brotulix/arduino-bottlerocket/arduino_nano_v3_pinout.jpg

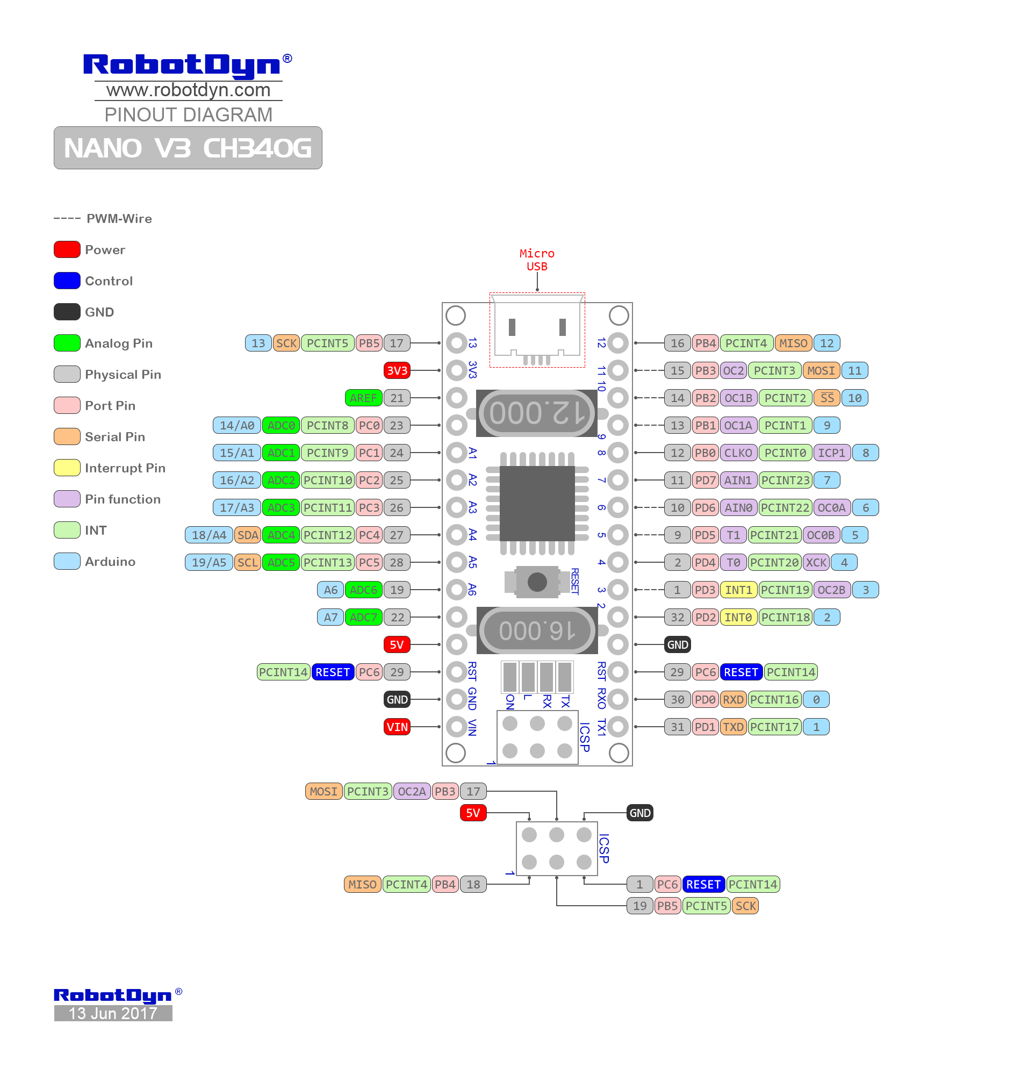
arduino_nano_v3_pinout.jpg
