brotulix/arduino-bottlerocket/doc/images/2019-07-19_Launch_02/Akselerasjon.png

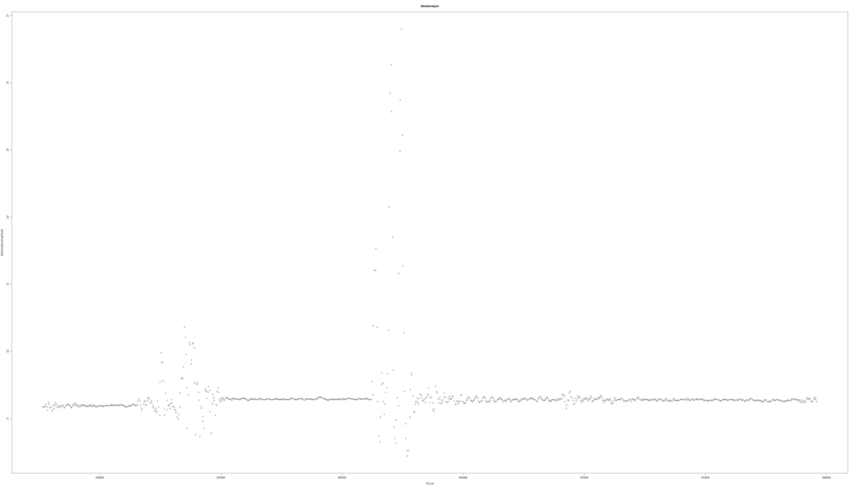
doc/images/2019-07-19_Launch_02/Akselerasjon.png
