brotulix/arduino-bottlerocket/doc/images/2019-07-19_Launch_02/Akszoom.png

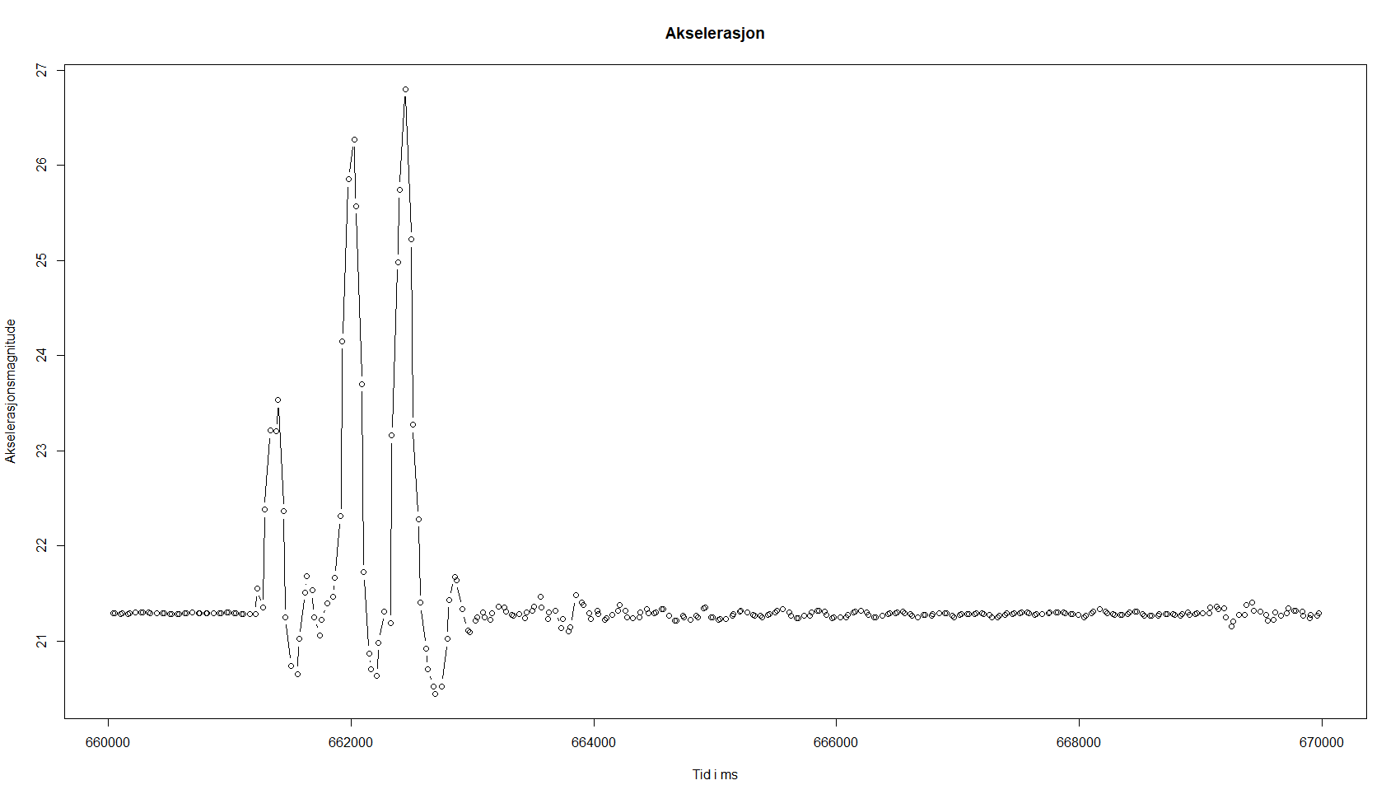
doc/images/2019-07-19_Launch_02/Akszoom.png
