brotulix/arduino-bottlerocket/doc/images/2019-07-19_Launch_02/Trykk_over_tid.png

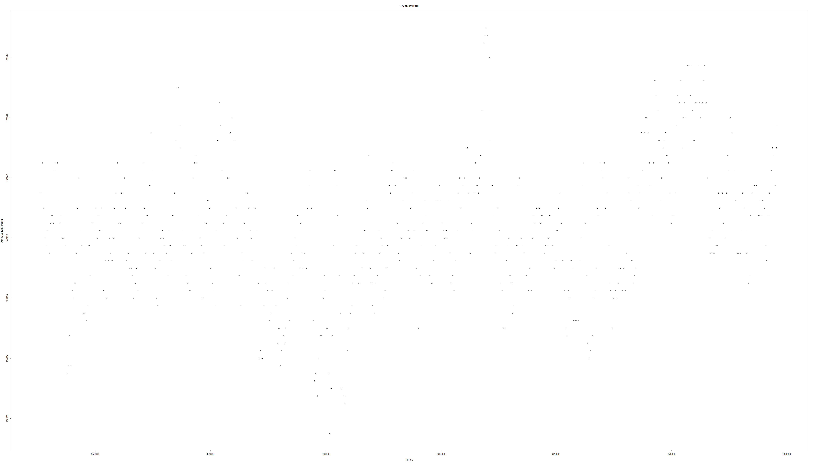
doc/images/2019-07-19_Launch_02/Trykk_over_tid.png
