brotulix/arduino-bottlerocket/doc/images/2019-07-19_Launch_02/Trykkliten.png

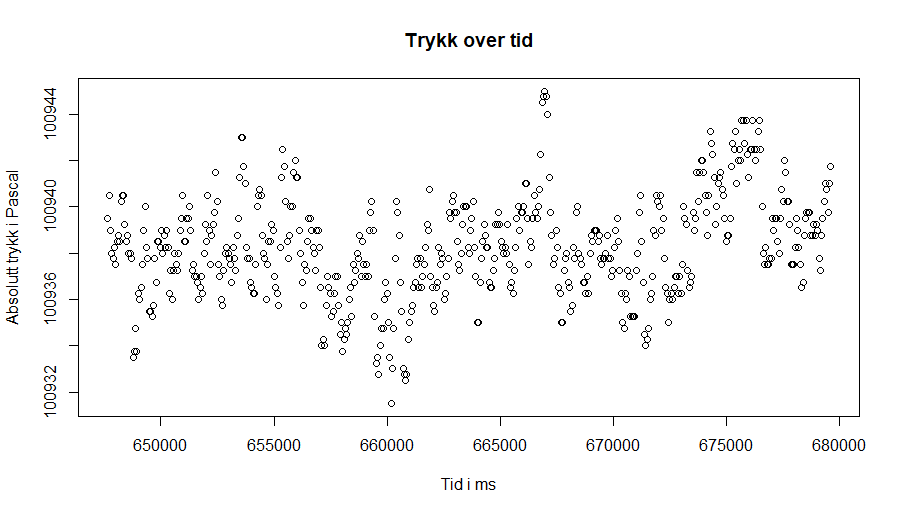
doc/images/2019-07-19_Launch_02/Trykkliten.png
