brotulix/arduino-bottlerocket/doc/images/Screenshot at 2019-07-07 14-47-54.png

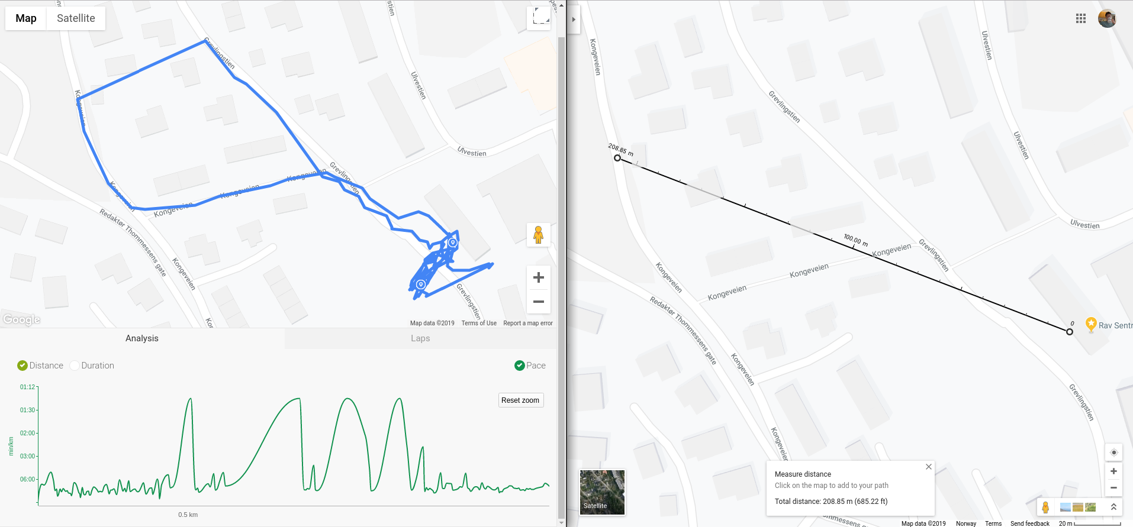
doc/images/Screenshot at 2019-07-07 14-47-54.png
