brotulix/arduino-bottlerocket/doc/images/Screenshot at 2019-07-08 00-21-22.png

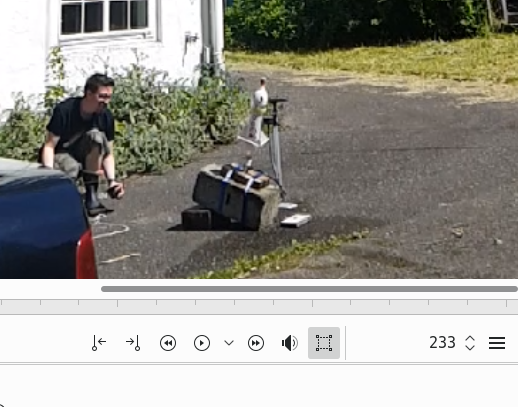
doc/images/Screenshot at 2019-07-08 00-21-22.png
