brotulix/arduino-bottlerocket/doc/images/Screenshot at 2019-07-08 00-22-48.png

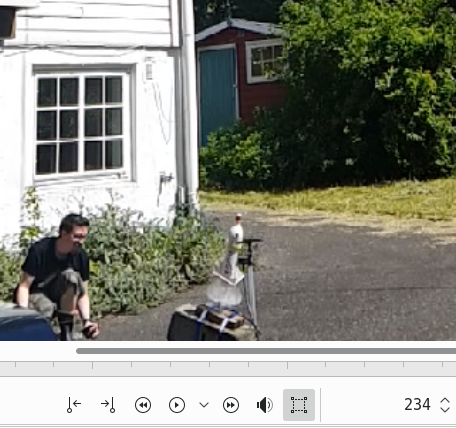
doc/images/Screenshot at 2019-07-08 00-22-48.png
