brotulix/arduino-bottlerocket/doc/images/Screenshot at 2019-07-19 22-26-23.png

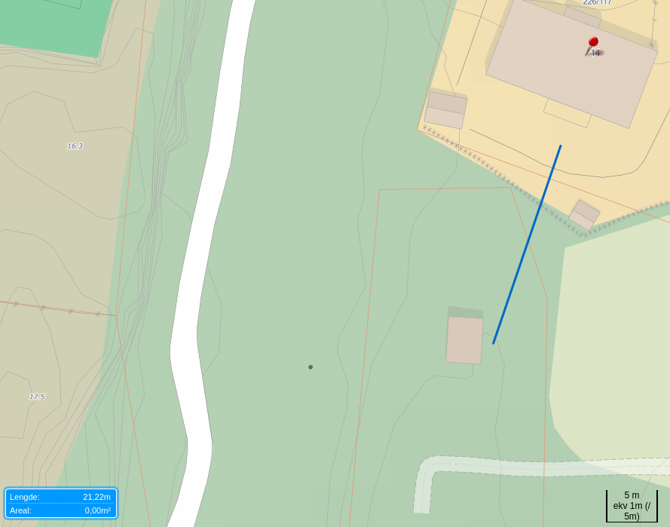
doc/images/Screenshot at 2019-07-19 22-26-23.png
