brotulix/arduino-bottlerocket/doc/2019-07-11_fishing_rod_test.ods

Sheet: Sheet1
Timestamp |  |  | prev_average | average | diff
20:57:13.899 161638 | R | A | 21.57 | 21.56 | 0
20:57:57.257 205033 | R | A | 21.56 | 21.56 | 0
20:57:57.334 205083 | R | A | 21.56 | 21.56 | 0
20:57:57.750 205177 | R | A | 21.56 | 21.56 | 0
20:57:58.126 205228 | R | A | 21.56 | 21.56 | 0
20:57:58.129 205322 | R | A | 21.56 | 21.56 | 0
20:57:58.455 205372 | R | A | 21.56 | 21.56 | 0
20:57:58.458 205466 | R | A | 21.57 | 21.56 | 0
20:57:58.465 205516 | R | A | 21.56 | 21.57 | 0
20:57:58.465 205611 | R | A | 21.57 | 21.57 | 0
20:57:58.465 205661 | R | A | 21.57 | 21.57 | 0
20:57:58.465 205755 | R | A | 21.57 | 21.56 | 0
20:57:58.468 205805 | R | A | 21.56 | 21.56 | 0
20:57:58.468 205899 | R | A | 21.56 | 21.56 | 0
20:57:58.473 205995 | R | A | 21.56 | 21.56 | 0
20:57:58.473 206091 | R | A | 21.55 | 21.55 | 0
20:57:58.473 206185 | R | A | 21.56 | 21.56 | 0
20:57:58.476 206235 | R | A | 21.56 | 21.56 | 0
20:57:58.552 206329 | R | A | 21.56 | 21.56 | 0
20:57:58.621 206380 | R | A | 21.56 | 21.56 | 0
20:57:58.705 206474 | R | A | 21.56 | 21.56 | 0
20:57:58.790 206524 | R | A | 21.56 | 21.56 | 0
20:57:58.875 206618 | R | A | 21.56 | 21.56 | 0
20:57:58.963 206668 | R | A | 21.56 | 21.56 | 0
20:57:58.985 206763 | R | A | 21.56 | 21.56 | 0
20:57:59.050 206813 | R | A | 21.56 | 21.56 | 0
20:57:59.133 206907 | R | A | 21.56 | 21.56 | 0
20:57:59.218 206956 | R | A | 21.56 | 21.56 | 0
20:57:59.304 207050 | R | A | 21.56 | 21.55 | 0
20:57:59.325 207101 | R | A | 21.55 | 21.55 | 0
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
00:11:13.429 1019994 | R | A | 23.49 | 23.49 | 0
00:11:13.481 1020044 | R | A | 23.49 | 23.49 | 0
00:11:13.569 1020138 | R | A | 23.49 | 23.49 | 0
00:11:13.611 1020188 | R | A | 23.49 | 23.49 | 0
00:11:13.700 1020282 | R | A | 23.5 | 23.49 | 0
00:11:16.763 1023347 | R | A | 23.49 | 23.49 | 0

Sheet: Sheet2
Timestamp |  |  | prev_average | average | diff
20:57:13.885 161602 | R | B | 100344 | 100346.38 | 2
20:57:57.270 205036 | R | B | 100340.13 | 100341 | 0
20:57:58.126 205180 | R | B | 100341 | 100342.38 | 1
20:57:58.131 205325 | R | B | 100342.38 | 100345.63 | 3
20:57:58.461 205469 | R | B | 100345.63 | 100347.5 | 1
20:57:58.465 205614 | R | B | 100347.5 | 100347.5 | 0
20:57:58.468 205758 | R | B | 100347.5 | 100345.88 | -1
20:57:58.468 205902 | R | B | 100345.88 | 100343.25 | -2
20:57:58.473 206045 | R | B | 100343.25 | 100342.63 | 0
20:57:58.473 206188 | R | B | 100342.63 | 100344.25 | 1
20:57:58.619 206332 | R | B | 100344.25 | 100343.5 | 0
20:57:58.707 206477 | R | B | 100343.5 | 100342.75 | 0
20:57:58.877 206621 | R | B | 100342.75 | 100343.25 | 0
20:57:59.048 206766 | R | B | 100343.25 | 100342.88 | 0
20:57:59.142 206910 | R | B | 100342.88 | 100343 | 0
20:57:59.308 207054 | R | B | 100343 | 100343.25 | 0
20:57:59.394 207153 | R | B | 100343.25 | 100342.75 | 0
20:57:59.565 207297 | R | B | 100342.75 | 100343.63 | 0
20:57:59.672 207441 | R | B | 100343.63 | 100343 | 0
20:57:59.821 207585 | R | B | 100343 | 100343.63 | 0
20:57:59.994 207730 | R | B | 100343.63 | 100342.5 | -1
20:58:00.164 207874 | R | B | 100342.5 | 100342.13 | 0
20:58:00.250 208018 | R | B | 100342.13 | 100340.5 | -1
20:58:00.421 208162 | R | B | 100340.5 | 100341.38 | 0
20:58:00.593 208307 | R | B | 100341.38 | 100342.63 | 1
20:58:00.679 208451 | R | B | 100342.63 | 100344.63 | 2
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
00:10:19.430 965964 | R | B | 100415.88 | 100415.38 | 0
00:10:19.600 966109 | R | B | 100415.38 | 100416.88 | 1
00:10:19.772 966253 | R | B | 100416.88 | 100417.38 | 0
00:10:19.859 966396 | R | B | 100417.38 | 100418 | 0
00:10:20.029 966542 | R | B | 100418 | 100418.25 | 0
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
