brotulix/arduino-bottlerocket/(threads)

Thread 3 (2019-07-04):

Implementer kommunikasjon over 433MHz

brotulix, 2019-07-04:
Få 433MHz-modulene konfigurert og fungerende.

brotulix, 2019-07-04:
Veldig lovende første prøve; plug & play på 9600 baud.
Må lese meg opp og skrive et Python-script og Arduino-driver for å sette opp baud rate til iallefall 19200. Definitivt verdt et forsøk å se om det går an å øke over dette også.

brotulix, 2019-07-08:
Første forsøk med å koble GPS direkte på modulen gikk ikke så bra... De første N meldingene gikk fint, men så begynte det å bli mye gibberish.
Jeg kobla på en Raspberry Pi som tok meldingene fra GPS på èn USB UART, filtrerte dem og spytta dem ut igjen på en annen USB UART. På den måten klarte jeg å få shippa over GPS-koordinater og kunne dra med meg Raspberryen på en tur rundt kvartalet, og fant ut at rekkevidden var på omtrent 200 meter line-of-sight.

Closed 2019-07-08.

Thread 4 (2019-07-08):

FET for å drive blinky blinky

brotulix, 2019-07-08:
Koble opp og test FET for å drive mer enn èn blinky blinky LED.

brotulix, 2019-07-08:
Var allerede implementert i software, nå også testet med hardware.

Closed 2019-07-08.

Thread 5 (2019-07-08):

FET for å en/disable servo når den ikke brukes

brotulix, 2019-07-08:
For å slippe at servoen står og jukker på akkurat feil vinkel enten på pad eller i recovery kan jeg tenke meg å styre supplyspenninga til den med en FET.

brotulix, 2019-07-08:
Implementert i software og testet med hardware.

Closed 2019-07-08.

Thread 9 (2019-07-08):

Funksjonstest på ekstern power

brotulix, 2019-07-08:
Kjør systemet på ekstern spenning
Sjekk at alle komponenter oppfører seg som forventa med ekstern spenning
Sjekk at spenningsavlesning fungerer
Sjekk at alle komponenter (inkludert low-battery-warning) oppfører seg som forventa med ekstern spenning helt ned til utladet batteri-spenning

brotulix, 2019-07-19:
Batteriavlesning trenger modifikasjon; spenninga leses ikke lenger nøyaktig når innspenning til Arduino blir for lav.
Ellers fungerer alt.

Closed 2019-07-19.
