brotulix/arduino-bottlerocket/botroc.ino

// If using eg. Visual Studio Code with Arduino plugin, ARDUINO may not be set:
#ifndef ARDUINO
#define ARDUINO 189
#endif

#include <Wire.h>
#include <Adafruit_Sensor.h>        // *modified* Adafruit Unified Sensor library
#include <Adafruit_BMP085_U.h>      // BMP085 Barometer
#include <Adafruit_ADXL345_U.h>     // ADXL345 Accelerometer
#include <Adafruit_HMC5883_U.h>     // HMC5883 Magnetometer
#include <Servo.h>

#define SET_BIT(a, b)   (a |= (0x1 << b))
#define CLEAR_BIT(a, b) (a &= ~(0x1 << b))
#define GET_BIT(a, b)   (a & (0x1 << b))

/*
#define INTSRC_INTERRUPT                        2
#define INTSRC_GYROMETER                        -1
#define INTSRC_BAROMETER                        4
#define INTSRC_THERMOMETER                      5
#define INTSRC_ACCELEROMETER                    6
#define INTSRC_MAGNETOMETER                     7
*/
#define SERVO_ENABLE_PIN                        7
#define BUZZER_PIN                              8
#define PARACHUTE_SERVO_PIN                     9
#define BLINKER_PIN                             10
#define I2C_SDA                                 18
#define I2C_SCL                                 19
#define BATTERY_VOLTAGE_PIN                     PIN_A2


#define STATUS_BAROMETER_DETECTED               0
#define STATUS_ACCELEROMETER_DETECTED           1
#define STATUS_GYROMETER_DETECTED               2
#define STATUS_MAGNETOMETER_DETECTED            3

#define STATUS_UPDATE                           0
#define STATUS_UPDATE_AVERAGE                   1
#define STATUS_REPORT                           2

#define STATE_GROUND_IDLE                       0   // ### Ground, idle state
#define STATE_GROUND_IDLE_ON_PAD                1   // ### Ground, on-pad idle state
#define STATE_GROUND_ARMED                      2   // ### Ground, armed state
#define STATE_AIRBORNE_OUTBOUND                 3   // ### Airborne, outbound state
#define STATE_AIRBORNE_DEPLOYMENT               4   // ### Airborne, deployment state
#define STATE_AIRBORNE_INBOUND                  5   // ### Airborne, inbound state
#define STATE_GROUND_RECOVERY                   6   // ### Ground, recovery state
#define STATE_GROUND_DATADUMP                   7   // ### Ground, data-dump state
#define STATE_MAX_STATE                         STATE_GROUND_RECOVERY

#define COMMAND_LINE_BUFFER_SIZE                16
#define COMMAND_LINE_APPEND_THRESHOLD           ((COMMAND_LINE_BUFFER_SIZE / 4) * 3)

#define SENSORS_NUM_VALUES                      8

typedef struct {
    float values[SENSORS_NUM_VALUES];
    float prev_average;
    float average;
    uint8_t filled_elements;
    uint8_t next_element_to_fill;
    uint16_t spare;
} savg;

typedef struct {
    uint32_t millis_previous_loop;
    uint16_t interval_read_accelerometer;
    uint16_t interval_read_barometer;
    uint16_t interval_read_magnetometer;
    uint16_t interval_average_accelerometer;
    uint16_t interval_average_barometer;
    uint16_t interval_average_magnetometer;
    uint16_t interval_print_accelerometer;
    uint16_t interval_print_barometer;
    uint16_t interval_print_magnetometer;
    uint16_t interval_check_battery;
    uint16_t limit_delta_accelerometer;
    uint16_t limit_delta_barometer;
    uint16_t limit_delta_magnetometer;
    uint16_t limit_battery_voltage;
    uint16_t time_to_next_update_accelerometer;
    uint16_t time_to_next_update_barometer;
    uint16_t time_to_next_update_magnetometer;
    uint16_t time_to_next_update_average_accelerometer;
    uint16_t time_to_next_update_average_barometer;
    uint16_t time_to_next_update_average_magnetometer;
    uint16_t time_to_next_report_accelerometer;
    uint16_t time_to_next_report_barometer;
    uint16_t time_to_next_report_magnetometer;
    uint16_t time_to_next_read_battery_voltage;
    uint16_t panic_timeout_outbound;
    uint16_t panic_timeout_inbound;
    uint16_t buzzer_frequency;
    uint8_t servo_safe;
    uint8_t servo_release;
} sconfig;

Adafruit_BMP085_Unified bmp = Adafruit_BMP085_Unified(24680);
Adafruit_HMC5883_Unified mag = Adafruit_HMC5883_Unified(12345);
Adafruit_ADXL345_Unified acc = Adafruit_ADXL345_Unified(13579);

Servo parachuteReleaseServo;

char cmdline[COMMAND_LINE_BUFFER_SIZE] = { 0 };
uint8_t cmdlength = 0;

sconfig configuration = {
    0,      // millis_previous_loop
    2,      // interval_read_accelerometer
    50,     // interval_read_barometer
    50,     // interval_read_magnetometer
    10,     // interval_average_accelerometer
    50,     // interval_average_barometer
    500,    // interval_average_magnetometer
    10,     // interval_print_accelerometer
    50,     // interval_print_barometer
    500,    // interval_print_magnetometer
    5000,   // interval_check_battery
    20,    // limit_delta_accelerometer
    10,     // limit_delta_barometer
    60,     // limit_delta_magnetometer
    730,    // limit_battery_voltage
    0,      // time_to_next_update_accelerometer
    0,      // time_to_next_update_barometer
    0,      // time_to_next_update_magnetometer
    0,      // time_to_next_update_average_accelerometer
    0,      // time_to_next_update_average_barometer
    0,      // time_to_next_update_average_magnetometer
    0,      // time_to_next_report_accelerometer
    0,      // time_to_next_report_barometer
    0,      // time_to_next_report_magnetometer
    0,      // time_to_next_read_battery_voltage
    3000,   // panic_timeout_outbound
    15000,   // panic_timeout_inbound
    4000,    // buzzer_frequency
    45,     // servo_safe
    0       // servo_release
};

savg valsBarometer         = {};
savg valsAccelerometer     = {};
savg valsMagnetometer      = {};

byte stateMachineState = STATE_GROUND_IDLE;

float peakAltitudePressure = -1.0;
float groundStationPressure = -1.0;
float unarmedMagnetometerMagnitude = -1.0;
float groundStationAccelerationMagnitude = -1.0;
float peakLaunchAverageAccelerationMagnitude = -1.0;

// How many consequitive positive barometer deltas to read in a row to say we're
//   steadily falling
#define SENSORS_BAROMETER_STRIKES   3
uint8_t barometerdeltastrikes = 3;

uint8_t panicActivate = 0;
int32_t panicTimer = -1;

void clearCommandBuffer()
{
    uint8_t cmdlength = 0;
    //Serial.println("Clearing command buffer...");
    for(cmdlength = COMMAND_LINE_BUFFER_SIZE; cmdlength > 0; cmdlength--)
    {
        cmdline[cmdlength-1] = '\0';
    }
}

uint8_t append32(savg *vals, float value)
{
    vals->values[vals->next_element_to_fill] = value;
    
    vals->next_element_to_fill++;
    if(vals->next_element_to_fill >= SENSORS_NUM_VALUES)
    {
        vals->next_element_to_fill -= SENSORS_NUM_VALUES;
    }
    
    if(vals->filled_elements < SENSORS_NUM_VALUES)
    {
        vals->filled_elements++;
    }
    

    return vals->filled_elements;
}

float vlen3D(float x, float y, float z)
{
    return sqrt(
        (x*x)
        +
        (y*y)
        +
        (z*z)
    );
}

float favg32(savg *vals)
{
    uint8_t i = 0;
    float sum = 0;
    float avg = 0;

    // Catch the first call.
    if(vals->filled_elements == 0)
    {
        return 0;
    }

    for(i = 0; i < vals->filled_elements; i++)
    {
        sum += vals->values[i];
    }

    avg = sum / vals->filled_elements;

    vals->prev_average = vals->average;
    vals->average = avg;

    return avg;

}

float sensorBarometerReadValue(uint8_t report)
{
    sensors_event_t event;
    float val = 0.0;

    bmp.getEvent(&event);

    if(event.pressure)
    {
        val = event.pressure * 100.0;
    }
    
    if(report)
    {
        Serial.print("B: ");
        Serial.println(val);
    }
    
    return val;
}

float sensorAccelerometerReadValue(uint8_t report)
{
    sensors_event_t event;

    acc.getEvent(&event);

    if(event.acceleration.x || event.acceleration.y || event.acceleration.z)
    {
        if(report)
        {
            Serial.print("A: ");
            Serial.print("[");
            Serial.print(event.acceleration.x);
            Serial.print(", ");
            Serial.print(event.acceleration.y);
            Serial.print(",  ");
            Serial.print(event.acceleration.z);
            Serial.println("]");
        }
        return vlen3D(event.acceleration.x, event.acceleration.y, event.acceleration.z);
    }
    else
    {
        if(report)
        {
            Serial.print("ERROR");
        }
        return 0.0;
    }
}

float sensorMagnetometerReadValue(uint8_t report)
{
    sensors_event_t event; 
    mag.getEvent(&event);

    if(event.magnetic.x || event.magnetic.y || event.magnetic.z)
    {
        if(report)
        {
            Serial.print("M: ");
            Serial.print("[");
            Serial.print(event.magnetic.x);
            Serial.print(", ");
            Serial.print(event.magnetic.y);
            Serial.print(",  ");
            Serial.print(event.magnetic.z);
            Serial.println("]");
        }
        return vlen3D(event.magnetic.x, event.magnetic.y, event.magnetic.z);
    }
    else
    {
        if(report)
        {
            Serial.print("ERROR");
        }
        return 0;
    }
    
}

uint8_t getInt16(uint16_t *num, uint8_t start, uint8_t stop)
{
    *num = 0;
    for(; start < stop; start++)
    {
        if(cmdline[start] >= '0' && cmdline[start] <= '9')
        {
            *num = *num * 10 + (cmdline[start] - '0');
        }
        else
        {
            Serial.println("E");
            return 0;
        }
    }
    return start;
}

uint8_t parseCommandConfiguration(uint8_t j, uint8_t len)
{
    uint8_t i = 0;
    uint16_t val = 0;

    if(j == len)
    {
        Serial.println("Dumping configuration!");
        
        //Serial.print("interval_read_accelerometer: ");
        Serial.println(configuration.interval_read_accelerometer);
        
        //Serial.print("interval_read_barometer: ");
        Serial.println(configuration.interval_read_barometer);
        
        //Serial.print("interval_read_magnetometer: ");
        Serial.println(configuration.interval_read_magnetometer);
        
        //Serial.print("interval_average_accelerometer: ");
        Serial.println(configuration.interval_average_accelerometer);
        
        //Serial.print("interval_average_barometer: ");
        Serial.println(configuration.interval_average_barometer);
        
        //Serial.print("interval_average_magnetometer: ");
        Serial.println(configuration.interval_average_magnetometer);
        
        //Serial.print("interval_print_accelerometer: ");
        Serial.println(configuration.interval_print_accelerometer);
        
        //Serial.print("interval_print_barometer: ");
        Serial.println(configuration.interval_print_barometer);
        
        //Serial.print("interval_print_barometer: ");
        Serial.println(configuration.interval_print_magnetometer);
        
        //Serial.print("panic_timeout_outbound: ");
        Serial.println(configuration.interval_check_battery);
        
        //Serial.print("limit_delta_accelerometer: ");
        Serial.println(configuration.limit_delta_accelerometer);
        
        //Serial.print("limit_delta_barometer: ");
        Serial.println(configuration.limit_delta_barometer);
        
        //Serial.print("limit_delta_magnetometer: ");
        Serial.println(configuration.limit_delta_magnetometer);
        
        //Serial.print("panic_timeout_outbound: ");
        Serial.println(configuration.limit_battery_voltage);

        //Serial.print("panic_timeout_outbound: ");
        Serial.println(configuration.panic_timeout_outbound);
        
        //Serial.print("panic_timeout_inbound: ");
        Serial.println(configuration.panic_timeout_inbound);
        
        //Serial.print("buzzer_frequency: ");
        Serial.println(configuration.buzzer_frequency);
        
        //Serial.print("servo_safe: ");
        Serial.println(configuration.servo_safe);
        
        //Serial.print("servo_release: ");
        Serial.println(configuration.servo_release);
        
        return j;
    }

    switch(cmdline[j++])
    {
        case 'B': // Buzzer frequency
        {
            i = getInt16(&val, j, len);
            if(i)
            {
                configuration.buzzer_frequency = val;
            }
            return i;
            break;
        }

        case 'I': // Intervals
        {
            switch(cmdline[j++])
            {
                case 'A': // Accelerometer
                {
                    switch(cmdline[j++])
                    {
                        case 'A': // Averaging
                        {
                            i = getInt16(&val, j, len);
                            if(i)
                            {
                                configuration.interval_average_accelerometer = val;
                            }
                            return i;
                            break;
                        }

                        case 'P': // Printing
                        {
                            i = getInt16(&val, j, len);
                            if(i)
                            {
                                configuration.interval_print_accelerometer = val;
                            }
                            return i;
                            break;
                        }

                        case 'R': // Read
                        {
                            i = getInt16(&val, j, len);
                            if(i)
                            {
                                configuration.interval_read_accelerometer = val;
                            }
                            return i;
                            break;
                        }
                    }
                    break;
                }

                case 'B': // Barometer
                {
                    switch(cmdline[j++])
                    {
                        case 'A': // Averaging
                        {
                            i = getInt16(&val, j, len);
                            if(i)
                            {
                                configuration.interval_average_barometer = val;
                            }
                            return i;
                            break;
                        }

                        case 'P': // Printing
                        {
                            i = getInt16(&val, j, len);
                            if(i)
                            {
                                configuration.interval_print_barometer = val;
                            }
                            return i;
                            break;
                        }

                        case 'R': // Read
                        {
                            i = getInt16(&val, j, len);
                            if(i)
                            {
                                configuration.interval_read_barometer = val;
                            }
                            return i;
                            break;
                        }
                    }
                    break;
                }

                case 'M': // Magnetometer
                {
                    switch(cmdline[j++])
                    {
                        case 'A': // Averaging
                        {
                            i = getInt16(&val, j, len);
                            if(i)
                            {
                                configuration.interval_average_magnetometer = val;
                            }
                            return i;
                            break;
                        }

                        case 'P': // Printing
                        {
                            i = getInt16(&val, j, len);
                            if(i)
                            {
                                configuration.interval_print_magnetometer = val;
                            }
                            return i;
                            break;
                        }

                        case 'R': // Read
                        {
                            i = getInt16(&val, j, len);
                            if(i)
                            {
                                configuration.interval_read_magnetometer = val;
                            }
                            return i;
                            break;
                        }
                    }
                    break;
                }
                
                case 'V': // Battery Voltage
                {
                    i = getInt16(&val, j, len);
                    if(i)
                    {
                        configuration.interval_check_battery = val;
                    }
                    return i;
                    break;
                }

                default:
                    break;
            }
            break;
        }
        
        case 'L': // Limits
        {
            //Serial.println("Limits");

            switch(cmdline[j++])
            {
                case 'A': // Accelerometer
                {
                    //Serial.println("Accelerometer");

                    i = getInt16(&val, j, len);
                    if(i)
                    {
                        configuration.limit_delta_accelerometer = val;
                    }
                    return i;
                    break;
                }

                case 'B': // Barometer
                {
                    i = getInt16(&val, j, len);
                    if(i)
                    {
                        configuration.limit_delta_barometer = val;
                    }
                    return i;
                    break;
                }

                case 'M': // Magnetometer
                {
                    i = getInt16(&val, j, len);
                    if(i)
                    {
                        configuration.limit_delta_magnetometer = val;
                    }
                    return i;
                    break;
                }

                case 'V': // Battery Voltage
                {
                    i = getInt16(&val, j, len);
                    if(i)
                    {
                        configuration.limit_battery_voltage = val;
                    }
                    return i;
                    break;
                }

                default:
                    break;
            }
            break;
        }

        case 'S': // Servo
        {
            switch(cmdline[j++])
            {
                case 'R': // Release
                {
                    i = getInt16(&val, j, len);
                    if(i)
                    {
                        configuration.servo_release = val;
                    }
                    return i;
                    break;
                }

                case 'S': // Safe
                {
                    i = getInt16(&val, j, len);
                    if(i)
                    {
                        configuration.servo_safe = val;
                    }
                    return i;
                    break;
                }
            }
            break;


        }
        
        case 'T': // Timeouts
        {
            //Serial.println("Timeouts");
            switch(cmdline[j++])
            {
                case 'I': // Inbound
                {
                    i = getInt16(&val, j, len);
                    if(i)
                    {
                        configuration.panic_timeout_inbound = val;
                    }
                    return i;
                    break;
                }

                case 'O': // Outbound
                {
                    i = getInt16(&val, j, len);
                    if(i)
                    {
                        configuration.panic_timeout_outbound = val;
                    }
                    return i;
                    break;
                }

                default:
                    break;
            }
            break;
        }
        
        default:
            break;
    }

    return j;
}

/** Remove all characters in array up to the specified character.
 * @param   i   The last character to remove (eg. linefeed).
 */
void stripCommand(uint8_t i)
{
    uint8_t j = 0;
    
    if(i == 0)
    {
        return;
    }

    if(i > COMMAND_LINE_BUFFER_SIZE)
    {
        // This is an error, but we "solve" it by clearing the whole buffer.
        i = COMMAND_LINE_BUFFER_SIZE;
    }
    else
    {
        // Shift the rest of the command buffer i characters to the left
        for(j = 0; j < COMMAND_LINE_BUFFER_SIZE; j++)
        {
            if(j < COMMAND_LINE_BUFFER_SIZE - (i + 1))
            {
                cmdline[j] = cmdline[j + i];
            }
            else
            {
                cmdline[j] = '\0';
            }
            
        }
    }
    
    // Decrement length counter
    if(i > cmdlength)
    {
        cmdlength = 0;
    }
    else
    {
        cmdlength -= i;
    }

    /*
    Serial.print("Command string: [");
    Serial.flush();
    for(j = 0; j < COMMAND_LINE_BUFFER_SIZE; j++)
    {
        Serial.print(cmdline[j] > 20 ? cmdline[j] : '.');
        Serial.flush();
    }
    Serial.println("]");
    Serial.flush();
    */
}

uint8_t parseCommand(void)
{
    uint8_t i = 0;
    uint8_t j = 0;
    
    // Find the first newline
    for(i = 0; i <= cmdlength; i++)
    {
        if(cmdline[i] == ';')
        {
            //Serial.print("Newline at position ");
            //Serial.println(i);
            //Serial.flush();
            break;
        }
    }

    if(i == 0)
    {
        return 1;
    }

    if(i > cmdlength)
    {
        //Serial.println("No newline found!");
        //Serial.flush();
        if(cmdlength <= COMMAND_LINE_APPEND_THRESHOLD)
        {
            // Not to worry, maybe a newline arrives shortly...
            return 0;
        }

        // We're above threshold for reading in new bytes,
        //   and there is no newline in our buffer!
        if(cmdlength > COMMAND_LINE_APPEND_THRESHOLD)
        {
            // Start shifting bytes to the left in search of a command
            return 1;
        }
    }

    if(i > 0)
    {
        // It can theoretically be a command at only 2 bytes ("P\n")
        switch(cmdline[j++])
        {
            Serial.print(millis());
            Serial.print(": ");

            case 'C': // Configuration
            {
                //Serial.print("Configuration command ");
                if(
                    (stateMachineState == STATE_GROUND_IDLE)
                    ||
                    (stateMachineState == STATE_GROUND_IDLE_ON_PAD)
                    ||
                    (stateMachineState == STATE_GROUND_RECOVERY)
                )
                {
                    //Serial.println("input");
                    j = parseCommandConfiguration(j, i);
                    if(j < i)
                    {
                        clearCommandBuffer();
                        //Serial.println("There were leftover characters!");
                    }
                    return j;
                }
                else
                {
                    //Serial.println("in wrong mode!");
                    // Ignore the command
                    return i;
                }
                break;
            }

            case 'D': // Debug
            {
                Serial.println("----- DEBUG -----");
                
                Serial.print("Current state is S");
                Serial.println(stateMachineState);
                Serial.print("System time is ");
                Serial.println(millis());
                Serial.print("Command buffer length: ");
                Serial.println(cmdlength);
                
                //sensorBarometerReadTemperature();
                
                Serial.print("Current Accelerometer value: ");
                Serial.println(sensorAccelerometerReadValue(1));

                Serial.print("Current Barometer value: ");
                Serial.println(sensorBarometerReadValue(1));

                Serial.print("Current Magnetometer value: ");
                Serial.println(sensorMagnetometerReadValue(1));

                doBarometerActions(0, ((1 << STATUS_REPORT)|(1 << STATUS_UPDATE)|(1 << STATUS_UPDATE_AVERAGE)), 1);
                
                doAccelerometerActions(0, ((1 << STATUS_REPORT)|(1 << STATUS_UPDATE)|(1 << STATUS_UPDATE_AVERAGE)), 1);
                
                doMagnetometerActions(0, ((1 << STATUS_REPORT)|(1 << STATUS_UPDATE)|(1 << STATUS_UPDATE_AVERAGE)), 1);

                Serial.print("Current buzzer frequency is ");
                Serial.print(configuration.buzzer_frequency);
                Serial.println(" Hz");

                Serial.print("Peak altitude pressure: ");
                Serial.println(peakAltitudePressure);


                return i;
                break;
            }

            case 'P': // Ping
            {
                Serial.println("P");
                return i;
                break;
            }
            
            case 'S': // State transition
            {
                if(j == i)
                {
                    // Report current state
                    Serial.print("S");
                    Serial.println(stateMachineState);
                    return i;
                }

                //Serial.print("State change ");
                j = (uint8_t)cmdline[j++] - 0x30;
                if(j > STATE_MAX_STATE)
                {
                    // Error!
                    Serial.println("error!");
                    return i;
                    break;
                }
                //Serial.print("from S");
                //Serial.print(stateMachineState);
                //Serial.print(" to S");
                //Serial.println(j);
                setState(j);
                return i;
                break;
            }
            
            default:
            {
                //Serial.println("E: Command not recognized.");
                Serial.println("E");
                return i;
                break;
            }
        } // switch(cmdline[0])
    } // if(i > 1)

    return 0;
} // parseCommand()

void displaySensorDetails(uint8_t sensorStatus)
{
    if(!sensorStatus)
    {
        Serial.println("No sensors detected!");
        return;
    }
    
    if(!(
        GET_BIT(sensorStatus, STATUS_BAROMETER_DETECTED) && 
        GET_BIT(sensorStatus, STATUS_MAGNETOMETER_DETECTED) && 
        GET_BIT(sensorStatus, STATUS_ACCELEROMETER_DETECTED)
    ))
    {
        Serial.println("E: At least one sensor not detected.");
    }
}

uint8_t doAccelerometerActions(uint16_t delta_millis, uint8_t force, uint8_t report)
{
    uint8_t update = 0;
    int32_t diff = 0;

    if(delta_millis >= configuration.time_to_next_update_average_accelerometer)
    {
        SET_BIT(update, STATUS_UPDATE_AVERAGE);
        configuration.time_to_next_update_average_accelerometer = configuration.interval_average_accelerometer;
    }
    else {
        CLEAR_BIT(update, STATUS_UPDATE_AVERAGE);
        configuration.time_to_next_update_average_accelerometer -= delta_millis;
    }

    if(GET_BIT(update, STATUS_UPDATE_AVERAGE) || GET_BIT(force, STATUS_UPDATE_AVERAGE))
    {
        //Serial.println();
        //Serial.print(millis());
        //Serial.println(": Aavg");
        favg32(&valsAccelerometer);
    }

    if(delta_millis >= configuration.time_to_next_report_accelerometer)
    {
        SET_BIT(update, STATUS_REPORT);
        configuration.time_to_next_report_accelerometer = configuration.interval_print_accelerometer;
    }
    else
    {
        CLEAR_BIT(update, STATUS_REPORT);
        configuration.time_to_next_report_accelerometer -= delta_millis;
    }

    if((report && GET_BIT(update, STATUS_REPORT)) || GET_BIT(force, STATUS_REPORT))
    {
        if(valsAccelerometer.filled_elements)
        {
            //Serial.println();
            Serial.print(millis());
            Serial.print("\tR\tA\t");

            //Serial.print("Previous Average: ");
            //Serial.print(valsAccelerometer.prev_average);
            //Serial.print("\t");
            //Serial.println(" m/s^2");

            //Serial.print("Average: ");
            Serial.print(valsAccelerometer.average);
            Serial.print("\t");
            //Serial.println(" m/s^2");

            if(valsAccelerometer.prev_average > valsAccelerometer.average)
            {
                diff = -1 * (valsAccelerometer.prev_average - valsAccelerometer.average);
            }
            else
            {
                diff = valsAccelerometer.average - valsAccelerometer.prev_average;
            }

            //Serial.print("Delta: ");
            Serial.print(diff);
            Serial.println();
            //Serial.println(" m/s^2");
        }
    }

    if(delta_millis >= configuration.time_to_next_update_accelerometer)
    {
        SET_BIT(update, STATUS_UPDATE);
        configuration.time_to_next_update_accelerometer = configuration.interval_read_accelerometer;
    }
    else {
        CLEAR_BIT(update, STATUS_UPDATE);
        configuration.time_to_next_update_accelerometer -= delta_millis;
    }

    if(GET_BIT(update, STATUS_UPDATE) || GET_BIT(force, STATUS_UPDATE))
    {
        //Serial.println();
        //Serial.print(millis());
        //Serial.println(": Aapd");
        append32(&valsAccelerometer, sensorAccelerometerReadValue(0));
    }

    return (update | force);
}

uint8_t doMagnetometerActions(uint16_t delta_millis, uint8_t force, uint8_t report)
{
    uint8_t update = 0;
    int32_t diff = 0;

    if(delta_millis >= configuration.time_to_next_update_average_magnetometer)
    {
        SET_BIT(update, STATUS_UPDATE_AVERAGE);
        configuration.time_to_next_update_average_magnetometer = configuration.interval_average_magnetometer;
    }
    else {
        CLEAR_BIT(update, STATUS_UPDATE_AVERAGE);
        configuration.time_to_next_update_average_magnetometer -= delta_millis;
    }

    if(GET_BIT(update, STATUS_UPDATE_AVERAGE) | GET_BIT(force, STATUS_UPDATE_AVERAGE))
    {
        //Serial.println();
        //Serial.print(millis());
        //Serial.println(": Mavg");
        favg32(&valsMagnetometer);
    }

    if(delta_millis >= configuration.time_to_next_report_magnetometer)
    {
        SET_BIT(update, STATUS_REPORT);
        configuration.time_to_next_report_magnetometer = configuration.interval_print_magnetometer;
    }
    else {
        CLEAR_BIT(update, STATUS_REPORT);
        configuration.time_to_next_report_magnetometer -= delta_millis;
    }

    if((report && GET_BIT(update, STATUS_REPORT)) || GET_BIT(force, STATUS_REPORT))
    {
        if(valsMagnetometer.filled_elements)
        {
            //Serial.println();
            Serial.print(millis());
            Serial.print("\tR\tM\t");
            //Serial.println(": Mrpt");

            //Serial.print("Previous Average: ");
            //Serial.print(valsMagnetometer.prev_average);
            //Serial.print("\t");
            //Serial.println(" uT");

            //Serial.print("Average: ");
            Serial.print(valsMagnetometer.average);
            Serial.print("\t");
            //Serial.println(" uT");

            if(valsMagnetometer.prev_average > valsMagnetometer.average)
            {
                diff = -1 * (valsMagnetometer.prev_average - valsMagnetometer.average);
            }
            else
            {
                diff = valsMagnetometer.average - valsMagnetometer.prev_average;
            }

            //Serial.print("Delta: ");
            Serial.print(diff);
            Serial.println();
            //Serial.println(" uT");
    }
    }

    if(delta_millis >= configuration.time_to_next_update_magnetometer)
    {
        update = 1;
        configuration.time_to_next_update_magnetometer = configuration.interval_read_magnetometer;
    }
    else {
        update = 0;
        configuration.time_to_next_update_magnetometer -= delta_millis;
    }

    if(GET_BIT(update, STATUS_UPDATE) || GET_BIT(force, STATUS_UPDATE))
    {
        //Serial.println();
        //Serial.print(millis());
        //Serial.println(": Mapd");
        append32(&valsMagnetometer, sensorMagnetometerReadValue(0));
    }

    return (update | force);
}

uint8_t doBarometerActions(uint16_t delta_millis, uint8_t force, uint8_t report)
{
    uint8_t update = 0;
    int32_t diff = 0;

    if(delta_millis >= configuration.time_to_next_update_average_barometer)
    {
        SET_BIT(update, STATUS_UPDATE_AVERAGE);
        configuration.time_to_next_update_average_barometer = configuration.interval_average_barometer;
    }
    else {
        CLEAR_BIT(update, STATUS_UPDATE_AVERAGE);
        configuration.time_to_next_update_average_barometer -= delta_millis;
    }

    if(GET_BIT(update, STATUS_UPDATE_AVERAGE) || GET_BIT(force, STATUS_UPDATE_AVERAGE))
    {
        //Serial.println();
        //Serial.print(millis());
        //Serial.println(": Bavg");
        favg32(&valsBarometer);
    }

    if(delta_millis >= configuration.time_to_next_report_barometer)
    {
        SET_BIT(update, STATUS_REPORT);
        configuration.time_to_next_report_barometer = configuration.interval_print_barometer;
    }
    else {
        CLEAR_BIT(update, STATUS_REPORT);
        configuration.time_to_next_report_barometer -= delta_millis;
    }

    if((report && GET_BIT(update, STATUS_REPORT)) || GET_BIT(force, STATUS_REPORT))
    {
        if(valsBarometer.filled_elements)
        {
            //Serial.println();
            Serial.print(millis());
            Serial.print("\tR\tB\t");
            //Serial.println(": Brpt");

            //Serial.print("Previous Average: ");
            //Serial.print(valsBarometer.prev_average);
            //Serial.print("\t");
            //Serial.println(" Pa");

            //Serial.print("Average: ");
            Serial.print(valsBarometer.average);
            Serial.print("\t");
            //Serial.println(" Pa");

            diff = (valsBarometer.average - valsBarometer.prev_average);

            //Serial.print("Delta: ");
            Serial.print(diff);
            Serial.println();
            //Serial.println(" Pa");
        }
    }

    if(delta_millis >= configuration.time_to_next_update_barometer)
    {
        SET_BIT(update, STATUS_UPDATE);
        configuration.time_to_next_update_barometer = configuration.interval_read_barometer;
    }
    else {
        CLEAR_BIT(update, STATUS_UPDATE);
        configuration.time_to_next_update_barometer -= delta_millis;
    }

    if(GET_BIT(update, STATUS_UPDATE) || GET_BIT(force, STATUS_UPDATE))
    {
        //Serial.println();
        //Serial.print(millis());
        //Serial.println(": Bapd");
        append32(&valsBarometer, sensorBarometerReadValue(0));
    }
}

void doBatteryActions(uint16_t delta_millis)
{
    uint8_t update = 0;
    uint16_t voltage = 0;
    
    if(delta_millis >= configuration.time_to_next_read_battery_voltage)
    {
        update = 1;
        configuration.time_to_next_read_battery_voltage = configuration.interval_check_battery;
    }
    else {
        update = 0;
        configuration.time_to_next_read_battery_voltage -= delta_millis;
    }

    if(update)
    {
        voltage = readBatteryVoltage();
        Serial.print(millis());
        Serial.print("\tR\tV\t");
        Serial.print(voltage);

        if(voltage < configuration.limit_battery_voltage)
        {
            tone(BUZZER_PIN, 440, configuration.interval_check_battery/2);
            Serial.print("\tBAT VOLT WARN");
        }
        Serial.println();
    }


}

uint16_t readBatteryVoltage()
{
    uint16_t adval = 0;
    adval = analogRead(BATTERY_VOLTAGE_PIN);
    return adval;
}

void panicTimerCountdown(uint16_t delta)
{
    if(!panicActivate)
    {
        panicTimer -= delta;
        if(panicTimer <= 0)
        {
            panicActivate = 1;
            Serial.println("Panic timeout!");
        }
    }
}

void panicTimerReset()
{
    switch(stateMachineState)
    {
        case STATE_AIRBORNE_INBOUND:
        {
            panicTimer = configuration.panic_timeout_inbound;
            break;
        }
        case STATE_AIRBORNE_OUTBOUND:
        {
            panicTimer = configuration.panic_timeout_outbound;
            break;
        }
        default:
        {
            panicTimer = 0;
        }
    }
    panicActivate = 0;
}

void releaseTheKrakenshoot()
{
    // Release the parachute by applying a different angle to the servo
    // or applying power to a motor
    // or something...
    digitalWrite(SERVO_ENABLE_PIN, HIGH);

    parachuteReleaseServo.write(configuration.servo_release);
    delay(250);
    digitalWrite(SERVO_ENABLE_PIN, LOW);
}

void resetParachute()
{
    digitalWrite(SERVO_ENABLE_PIN, HIGH);
    parachuteReleaseServo.write(configuration.servo_safe);
    delay(250);
    digitalWrite(SERVO_ENABLE_PIN, LOW);
}


void enableAudioVisualBeacon()
{
    // Toggle power to audiovisual beacon
    digitalWrite(BLINKER_PIN, HIGH);
    tone(BUZZER_PIN, configuration.buzzer_frequency, 250);
}

void disableAudioVisualBeacon()
{
    // Toggle power to audiovisual beacon
    digitalWrite(BLINKER_PIN, LOW);
    delay(25);
}


void setState(uint8_t newState)
{
    uint8_t set = STATE_GROUND_IDLE;
    uint16_t diff = 0;
    
    if(newState <= STATE_MAX_STATE)
    {
        set = newState;
    }

    Serial.print(millis());
    Serial.print(": S");
    Serial.print(stateMachineState);
    Serial.print(" -> S");
    Serial.println(set);

    stateMachineState = set;
    
    switch(stateMachineState)
    {
        default:
        case STATE_GROUND_IDLE:
        {
            disableAudioVisualBeacon();
            panicTimerReset();
            break;
        }
        case STATE_GROUND_IDLE_ON_PAD:
        {
            disableAudioVisualBeacon();

            // Make sure we have something in the arrays for small initial magnitude deltas
            if(valsAccelerometer.filled_elements < SENSORS_NUM_VALUES)
            {

                for(diff = 0; diff < SENSORS_NUM_VALUES; diff++)
                {
                    doBarometerActions(0, ((1 << STATUS_UPDATE)|(1 << STATUS_UPDATE_AVERAGE)), 0);
                    
                    doAccelerometerActions(0, ((1 << STATUS_UPDATE)|(1 << STATUS_UPDATE_AVERAGE)), 0);
                    
                    doMagnetometerActions(0, ((1 << STATUS_UPDATE)|(1 << STATUS_UPDATE_AVERAGE)), 0);


                }
            }

            groundStationAccelerationMagnitude = valsAccelerometer.average;
            groundStationPressure = valsBarometer.average;
            peakAltitudePressure = valsBarometer.average;

            panicTimerReset();
            resetParachute();
            break;
        }
        case STATE_GROUND_ARMED:
        {
            disableAudioVisualBeacon();
            panicTimerReset();
            break;
        }
        case STATE_AIRBORNE_OUTBOUND:
        {
            disableAudioVisualBeacon();
            barometerdeltastrikes = SENSORS_BAROMETER_STRIKES;
            peakAltitudePressure = groundStationPressure;//valsBarometer.average;
            panicTimerReset();
            break;
        }
        case STATE_AIRBORNE_DEPLOYMENT:
        {
            disableAudioVisualBeacon();
            break;
        }
        case STATE_AIRBORNE_INBOUND:
        {
            disableAudioVisualBeacon();
            resetParachute();
            panicTimerReset();
            break;
        }
        case STATE_GROUND_RECOVERY:
        {
            enableAudioVisualBeacon();
            panicTimerReset();
            break;
        }
        case STATE_GROUND_DATADUMP:
        {
            disableAudioVisualBeacon();
            break;
        }

    }
}

void stateMachine(uint16_t delta_millis)
{
    int32_t diff = 0;
    doBatteryActions(delta_millis);
    switch(stateMachineState)
    {
        case STATE_GROUND_IDLE_ON_PAD:
        {
            // Keep watch on idle acceleration
            diff = doAccelerometerActions(delta_millis, 0, 0);
            if(GET_BIT(diff, STATUS_UPDATE_AVERAGE))
            {
                groundStationAccelerationMagnitude = valsAccelerometer.average;
            }
            diff = 0;
                    
            // Keep watch on arming trigger
            diff = doMagnetometerActions(delta_millis, 0, 1);
            if(GET_BIT(diff, STATUS_UPDATE_AVERAGE))
            {
                //unarmedMagnetometerMagnitude = valsMagnetometer.average;

                }
            diff = 0;

            // Keep watch on barometer, probably not the fastest changes, but we don't want a high magnitude just as we arm...
            diff = doBarometerActions(delta_millis, 0, 0);
            if(GET_BIT(diff, STATUS_UPDATE_AVERAGE))
            {
                groundStationPressure = valsBarometer.average;
            }
            diff = 0;

            // Magnetometer
            if(valsMagnetometer.prev_average > valsMagnetometer.average)
            {
                diff = valsMagnetometer.prev_average - valsMagnetometer.average;
            }
            else
            {
                diff = valsMagnetometer.average - valsMagnetometer.prev_average;
            }
            
            if(diff > configuration.limit_delta_magnetometer)
            {
                // Current average is no longer the unarmed value!
                //unarmedMagnetometerMagnitude = valsAccelerometer.prev_average;
                
                Serial.print(millis());
                Serial.println(": MAGNETOMETER MAGNITUDE ABOVE THRESHOLD");
                setState(STATE_GROUND_ARMED);
            }
            break;
        }
        
        case STATE_GROUND_ARMED:
        {
            // Check the two possible launch-indicative magnutides
            doAccelerometerActions(delta_millis, 0, 1);


            diff = doBarometerActions(delta_millis, 0, 1);
            if(GET_BIT(diff, STATUS_UPDATE_AVERAGE))
            {
                peakAltitudePressure = valsBarometer.average;
            }

            doMagnetometerActions(delta_millis, 0, 0);

            // Accelerometer
            diff = abs(valsAccelerometer.average - groundStationAccelerationMagnitude);
            
            if(diff > configuration.limit_delta_accelerometer)
            {
                Serial.print(millis());
                Serial.println(": ACCELEROMETER MAGNITUDE ABOVE THRESHOLD");
                setState(STATE_AIRBORNE_OUTBOUND);
            }

            // Barometer
            diff = abs(valsBarometer.average - groundStationPressure);
            
            if(diff > configuration.limit_delta_barometer)
            {
                Serial.print(millis());
                Serial.println(": BAROMETER MAGNITUDE ABOVE THRESHOLD");
                setState(STATE_AIRBORNE_OUTBOUND);
            }

            break;
        }
        
        case STATE_AIRBORNE_OUTBOUND:
        {
            panicTimerCountdown(delta_millis);

            doAccelerometerActions(delta_millis, 0, 1);
            doBarometerActions(delta_millis, 0, 1);
            doMagnetometerActions(delta_millis, 0, 0);

            // Check for lowest pressure yet
            if(valsBarometer.average < peakAltitudePressure)
            {
                peakAltitudePressure = valsBarometer.average;
            }

            if(valsAccelerometer.average > peakLaunchAverageAccelerationMagnitude)
            {
                peakLaunchAverageAccelerationMagnitude = valsAccelerometer.average;
            }

            diff = 0;
            
            // count down positive barometer deltas, indicating a decreasing height
            // A single positive value could perhaps simply be from pressure oscillations inside the payload capsule due to turbulence during launch, so we could get a premature deployment of parachute?
            if(valsBarometer.average < groundStationPressure)
            {
                if((valsBarometer.average - peakAltitudePressure) > configuration.limit_delta_barometer)
                {
                    Serial.print(millis());
                    Serial.print(": BAROMETER MAGNITUDE ABOVE THRESHOLD (");
                    Serial.print(diff);
                    Serial.print(">");
                    Serial.print(configuration.limit_delta_barometer);
                    Serial.println(")");

                    barometerdeltastrikes--;
                }
            }

            if(barometerdeltastrikes == 0)
            {
                Serial.print(millis());
                Serial.println(": THREE STRIKES; DEPLOYING");
                setState(STATE_AIRBORNE_DEPLOYMENT);
            }

            if(panicActivate)
            {
                Serial.print(millis());
                Serial.println(": DEPLOYING DUE TO PANIC TIMEOUT");
                setState(STATE_AIRBORNE_DEPLOYMENT);
            }

            break;
        }
        
        case STATE_AIRBORNE_DEPLOYMENT:
        {
            releaseTheKrakenshoot();
            setState(STATE_AIRBORNE_INBOUND);
            break;
        }
        
        case STATE_AIRBORNE_INBOUND:
        {
            panicTimerCountdown(delta_millis);

            doAccelerometerActions(delta_millis, 0, 1);
            doBarometerActions(delta_millis, 0, 1);
            doMagnetometerActions(delta_millis, 0, 0);

            if(panicActivate)
            {
                Serial.print(millis());
                Serial.println(": Activating locator beacon due to panic timeout.");
                setState(STATE_GROUND_RECOVERY);
            }
            break;
        }
        
        case STATE_GROUND_RECOVERY:
        {
            enableAudioVisualBeacon();
            
            // Wait for RBF to be re-applied
            doAccelerometerActions(delta_millis, 0, 0);
            doBarometerActions(delta_millis, 0, 0);
            doMagnetometerActions(delta_millis, 0, 1);
            
            // Magnetometer
            diff = abs(valsMagnetometer.average - valsMagnetometer.prev_average);
            
            if(diff > configuration.limit_delta_magnetometer)
            {
                Serial.println("MAGNETOMETER MAGNITUDE ABOVE THRESHOLD");
                setState(STATE_GROUND_IDLE);
                //setState(STATE_GROUND_DATADUMP);
            }

            break;
        }
        
        case STATE_GROUND_DATADUMP:
        {
            // Not really doing anything
            break;
        }

        default:
        case STATE_GROUND_IDLE:
        {
            break;
        }
    }
}

/** Check for bytes in UART receive buffer, and append them to our own command
 *    buffer, or at least as many as there is room for at the moment.
 */
void grabSerial()
{
    uint8_t cmdlen = 0;
    uint8_t i = 0;
    
    // Only get more data for command buffer if it's below threshold.
    if(cmdlength > COMMAND_LINE_APPEND_THRESHOLD)
    {
        return;
    }

    // Check for bytes in UART receive buffer
    cmdlen = Serial.available();
    if(cmdlen > 0)
    {
        // Don't try to overfill the command buffer
        if((cmdlength + cmdlen) > COMMAND_LINE_BUFFER_SIZE)
        {
            // Only fill it...
            cmdlen = COMMAND_LINE_BUFFER_SIZE - cmdlength;
        }

        i = Serial.readBytes((char*)(&cmdline[cmdlength]), cmdlen);
        
        //Serial.print("Read ");
        //Serial.print(i);
        //Serial.print(" of ");
        //Serial.print(cmdlen);
        //Serial.println(" bytes");
        
        cmdlength += i;

        // Don't try to terminate past end of buffer
        if(cmdlength == COMMAND_LINE_BUFFER_SIZE)
        {
            //Serial.println("Command buffer at capacity!");
            return;
        }
        if(cmdlength > COMMAND_LINE_BUFFER_SIZE)
        {
            Serial.println("E: Command buffer capacity exceeded!");
            clearCommandBuffer();
            return;
        }
        
        cmdline[cmdlength] = '\0';

    }

}

void setup()
{
    uint8_t sensorStatus = 0;
    int16_t servoPosition = configuration.servo_safe;
    Serial.begin(115200);
    Serial.println("setup() begins");

    delay(1000);

    /*
    Serial.print("UART RX Buffer size: ");
    Serial.println(SERIAL_RX_BUFFER_SIZE);

    Serial.print("Command line buffer size: ");
    Serial.println(COMMAND_LINE_BUFFER_SIZE);

    Serial.print("Command line fill threshold: ");
    Serial.println(COMMAND_LINE_APPEND_THRESHOLD);
    */
    
    clearCommandBuffer();
    
    /*
    Serial.print("Command line length: ");
    Serial.println(cmdlength);
    */
    
    Serial.println("Setting up pins...");

    pinMode(BUZZER_PIN, OUTPUT);
    pinMode(PARACHUTE_SERVO_PIN, OUTPUT);
    pinMode(SERVO_ENABLE_PIN, OUTPUT);
    pinMode(BLINKER_PIN, OUTPUT);

    delay(1000);

    //Serial.println("Initializing parachute release servo...");
    
    parachuteReleaseServo.attach(PARACHUTE_SERVO_PIN);

    //Serial.println("Safe position...");

    resetParachute();
    //parachuteReleaseServo.write(configuration.servo_safe);

    delay(1000);

    //Serial.println("Traversing...");
    //
    //for (servoPosition = 180; servoPosition >= -180; servoPosition -= 3)
    //{
    //    Serial.println(servoPosition);
    //    parachuteReleaseServo.write(servoPosition);
    //    delay(500);
    //}
    //
    //delay(3000);
    //
    //Serial.println("Return to safe...");
    //
    //parachuteReleaseServo.write(configuration.servo_safe);

    Serial.println("Initializing sensors...");
    
    //Serial.println("Barometer...");
    SET_BIT(sensorStatus, STATUS_BAROMETER_DETECTED);
    if (!bmp.begin()) {
        Serial.println("BE");
        CLEAR_BIT(sensorStatus, STATUS_BAROMETER_DETECTED);
    }

    // nothing to set

    //Serial.println("Magnetometer...");
    SET_BIT(sensorStatus, STATUS_MAGNETOMETER_DETECTED);
    if(!mag.begin())
    {
        Serial.println("ME");
        CLEAR_BIT(sensorStatus, STATUS_MAGNETOMETER_DETECTED);
    }

    //mag.setMagGain();

    //Serial.println("Accelerometer...");
    SET_BIT(sensorStatus, STATUS_ACCELEROMETER_DETECTED);
    if(!acc.begin())
    {
        Serial.println("AE");
        CLEAR_BIT(sensorStatus, STATUS_ACCELEROMETER_DETECTED);
    }

    acc.setDataRate(ADXL345_DATARATE_800_HZ);
    acc.setRange(ADXL345_RANGE_16_G);

    // At least one sensor was initialized...
    displaySensorDetails(sensorStatus);

    Serial.print("setup() ends at ");
    Serial.println(millis());
}

uint16_t getDeltaMillis()
{
    uint16_t delta_millis = 0;
    uint32_t this_millis = millis();

    // Check for wrap-around of millis counter
    if(this_millis < configuration.millis_previous_loop)
    {
        // Add the remainder until wrap-around for previous loop
        delta_millis = (uint32_t)-1 - configuration.millis_previous_loop;

        // Add this loop's millis
        delta_millis += this_millis;
    }
    else
    {
        delta_millis = this_millis - configuration.millis_previous_loop;
    }

    configuration.millis_previous_loop = this_millis;

    return delta_millis;
}

void loop()
{

    uint8_t i = 0;
    uint16_t delta_millis = 0;
    delta_millis = getDeltaMillis();
    
    grabSerial();

    i = parseCommand();

    if(i > 0)
    {
        stripCommand(i);
    }

    stateMachine(delta_millis);

    delay(10);
}
