brotulix/arduino-bottlerocket/(commit log)

2019-06-23 Adafruit Unified Sensor, State Machine skeleton.
2019-06-23 Shorter, correcter commandline. More skeleton.
    [botroc.ino]
2019-06-25 Added accelerometer and magnetometer reading. Doesn't handle accelerometer magnitude quite right yet. May want to add a fastmath version of sqrt?
    [botroc.ino]
2019-06-27 UNTESTED Added provisions for countdown-based update timers for readings, averages and reporting.
2019-07-01 Minor fixes. Some debug print.
    [botroc.ino]
2019-07-01 Added 16/32 bit selector for barometer. Adafruit's generic library is using too much dynamic memory.
    [botroc.ino]
2019-07-04 Using brxlib instead of Adafruit sensor libraries.
2019-07-04 Switching to float for simplicity's sake.
2019-07-04 Dynamic value buffer size. Started a ground control python script. Initial measurements on current draw for RF link.
2019-07-08 Loads of changes. Range test indicates around 200 meters LOS range. We're dealing with approximately 50ms of thrust (~480fps). 30 meters altitude ~= 300 Pa; multiplying delta for better threshold.
2019-07-08 Servo enable to conserve power.
2019-07-12 Added battery voltage monitoring.
2019-07-19 Wider range for accelerometer. Increased averaging.
2019-07-19 Various test logs.
    [serial_20190715_215458_A.ods, serial_20190715_215637_A.ods]
